DaveBben/Soil_Moisture_Transmitter_Reciver/schematic_pcb_gerber_files/PCB_PCB_Wireless Soil Sensor_2021-07-25.png

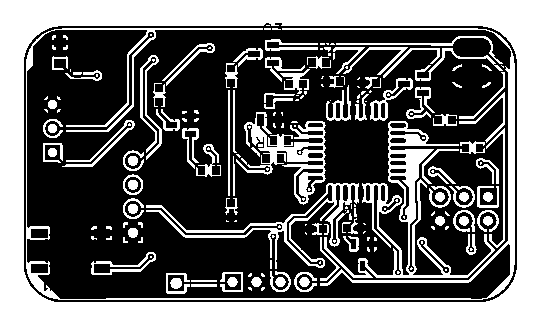
schematic_pcb_gerber_files/PCB_PCB_Wireless Soil Sensor_2021-07-25.png
