DaveBben/Soil_Moisture_Transmitter_Reciver/schematic_pcb_gerber_files/BOM_PCB_Wireless Soil Sensor_2021-07-25.csv

ID | Name | Designator | Footprint | Quantity | Manufacturer Part | Manufacturer | Supplier | Supplier Part | Price | Pins | JLCPCB Part Class
1 | 10K | R4,R1,R6,R7 | R0603 | 4 | 0603WAF1002T5E | UniOhm | LCSC | C25804 | 0.001 | 2 | Basic Part
2 | 210-92-03GB01 | H2 | HDR-TH_6P-P2.54-V-R2-C3-S2.54 | 1 | 210-92-03GB01 | PINREX | LCSC | C390690 | 0.02 | 6 | Extended Part
3 | MF254V-11-04-0540 | H3 | HDR-TH_4P-P2.54-V-F | 1 | MF254V-11-04-0540 | XFCN | LCSC | C509262 | 0.169 | 4 | Extended Part
4 | PM254V-11-04-H85 | H4 | HDR-TH_4P-P2.54-V-F | 1 | PM254V-11-04-H85 | XFCN | LCSC | C541851 | 0.108 | 4 | Extended Part
5 | PM254V-11-03-H85 | H5 | HDR-TH_3P-P2.54-V-F | 1 | PM254V-11-03-H85 | XFCN | LCSC | C541850 | 0.104 | 3 | Extended Part
6 | FC-2012HRK-620D | LED1 | LED0805-RD | 1 | FC-2012HRK-620D | NATIONSTAR | LCSC | C84256 | 0.012 | 2 | Basic Part
7 | PIN1X1 | PH1 | PINHEADER_01X1 | 1 | Pin_Header_5 |  |  |  |  | 1
8 | S9013 J3 | Q1,Q4 | SOT-23-3_L2.9-W1.3-P1.90-LS2.4-BR | 2 | S9013 J3 | CJ | LCSC | C6749 | 0.021 | 3 | Basic Part
9 | S9012 2T1 | Q2,Q3 | SOT-23-3_L2.9-W1.3-P1.90-LS2.4-BR | 2 | S9012 2T1 | CJ | LCSC | C8543 | 0.019 | 3 | Basic Part
10 | 47K | R2,R5 | R0603 | 2 | 0603WAF4702T5E | UniOhm | LCSC | C25819 | 0.001 | 2 | Basic Part
11 | 1K | R8,R9 | R0603 | 2 | 0603WAF1001T5E | UniOhm | LCSC | C21190 | 0.001 | 2 | Basic Part
12 | TS-1187A-C-C-B | SW1 | SW-SMD_4P-L5.1-W5.1-P3.70-LS6.5-TL-2 | 1 | TS-1187A-C-C-B | XKB Enterprise | LCSC | C318889 | 0.024 | 4 | Extended Part
13 | ATMEGA328P-AU | U1 | TQFP-32_L7.0-W7.0-P0.80-LS9.0-BL | 1 | ATMEGA328P-AU | MICROCHIP | LCSC | C14877 | 4.031 | 32 | Basic Part
14 | XC6206P332MR | U2 | SOT-23-3_L2.9-W1.6-P1.90-LS2.8-BR | 1 | XC6206P332MR | TOREX | LCSC | C5446 | 0.094 | 3 | Basic Part
15 | 2 Solder Pads | U4 | 2 SOLDER PADS | 1 | Solder Pads x2 |  |  |  |  | 2
16 | 100nF | C5,C6,C7,C8 | C0603 | 4 | CC0603KRX7R9BB104 | YAGEO | LCSC | C14663 | 0.003 | 2 | Basic Part
17 | 4.7K | R3 | R0603 | 1 | 0603WAF4701T5E | UniOhm | LCSC | C23162 | 0.001 | 2 | Basic Part
18 | 110 | R10 | R0603 | 1 | 0603WAF1100T5E | UniOhm | LCSC | C22781 | 0.001 | 2 | Basic Part
