DaveBben/Soil_Moisture_Transmitter_Reciver/(list of files, drawings)

Other design files:
schematic_pcb_gerber_files/PCB_PCB_Wireless Soil Sensor_2021-07-25.json
